Josefarc/TEI-201-Secci-n-4-Grupo-9/hardware/fotos/v1_03_detalle_conexiones_hx711.jpg.jpeg

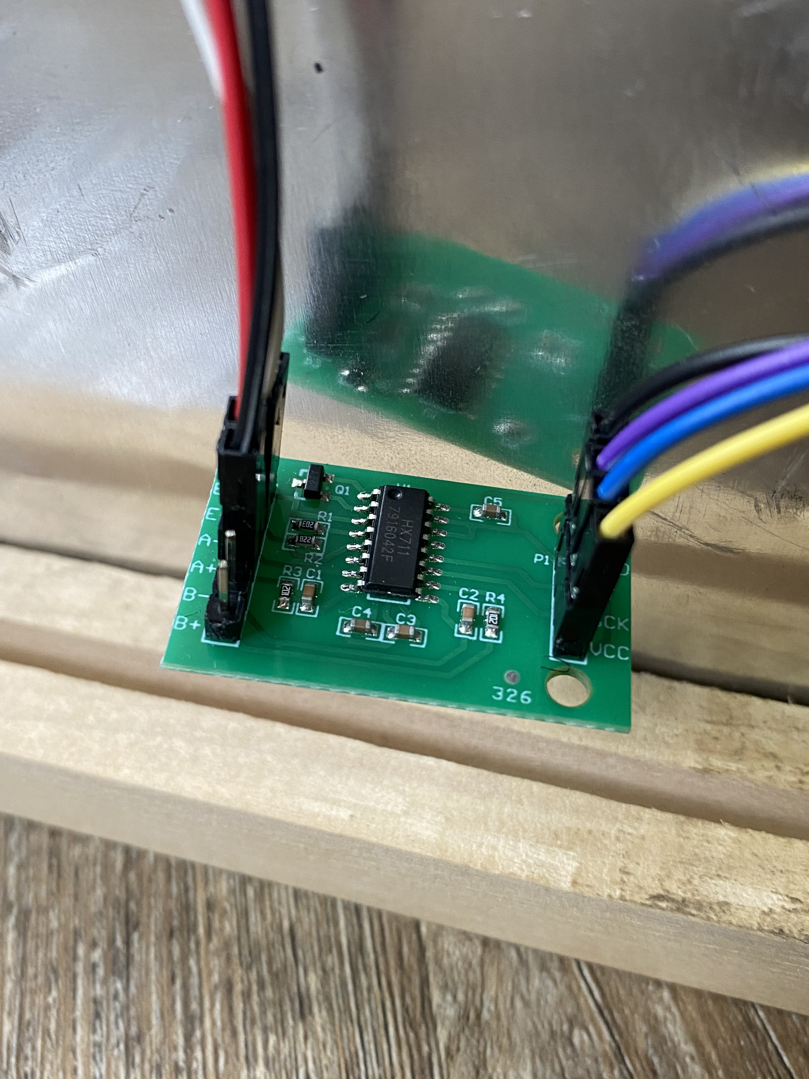
hardware/fotos/v1_03_detalle_conexiones_hx711.jpg.jpeg
