Josefarc/TEI-201-Secci-n-4-Grupo-9/diseno_3d/fusion360/README.md

## Nota para el ayudante — Entrega 2

En las carpetas de renders, Fusion y planos, la versión marcada como final es la que se debe evaluar para el Avance 2. Las demás se mantienen como historial de diseño, para que todo el equipo tenga visibilidad del progreso del proyecto.

El principal desafío pendiente es llevar el sistema a un mat de mayor área, con un diseño que se integre a la estética del dormitorio.

# Archivos Fusion 360

## Archivos Requeridos

### `modelo_completo_v3.f3d`
Archivo principal con **historial de cambios completo**

**DEBE INCLUIR:**
-  Todos los componentes modelados
-  Ensamble completo funcional
-  Historial de diseño (timeline)
-  Materiales asignados
-  Constraints y relaciones

---

## Estructura del Modelo

### Componentes (Components)
```
Ensamble_Principal
├── Encapsulado_Inferior
├── Encapsulado_Superior
├── ESP32_DevKit
├── Sensor_DHT22
├── LED_Indicador
├── Soporte_Bateria
├── Bracket_Montaje
└── Tornilleria
```

### Uniones (Joints)
Documentar las juntas principales y sus restricciones

### Parámetros
Listar parámetros principales utilizados:
- `ancho_total = 120mm`
- `alto_total = 80mm`
- `grosor_pared = 2mm`

---

## Instrucciones de Apertura

1. Abrir Fusion 360
2. File > Open > Seleccionar archivo `.f3d`
3. Verificar que todas las referencias están cargadas
4. Revisar timeline para ver historial

---

## Versiones

| Versión | Fecha | Cambios Principales |
|---|---|---|
| v3.0 | [Fecha] | Versión final para Avance #3 |
| v2.1 | [Fecha] | Ajustes post Avance #2 |
| v1.0 | [Fecha] | Primera versión funcional |

---
