Josefarc/TEI-201-Secci-n-4-Grupo-9/hardware/fotos/README.md

# Fotografías del Prototipo

## Requisitos de las Fotos

### Calidad
- **Resolución mínima:** 1920x1080 px
- **Formato:** JPG o PNG
- **Iluminación:** Buena iluminación natural o artificial uniforme
- **Fondo:** Neutro y sin distracciones

### Tomas Requeridas

1. **Vista general del prototipo completo**
2. **Vista del circuito interno**
3. **Detalle de conexiones críticas**
4. **Vista de sensores montados**
5. **Vista de actuadores**
6. **Encapsulado cerrado (si aplica)**
7. **Prototipo en contexto de uso**

---

## Nomenclatura
- Numerar según orden: `01_`, `02_`, etc.
- Usar nombres descriptivos
- Incluir versión: `v1_01_vista_general.jpg`

---

## Fotos de la Iteración 1 (v1)

| Archivo | Descripción |
|---|---|
| `v1_01_vista_general.jpg` | Sistema completo: prototipo del mat y circuito del control lado a lado |
| `v1_02_circuito_interno_mat.jpg` | Electrónica del mat (Wemos D1, HX711 y cableado desde las celdas) vista por debajo |
| `v1_03_detalle_conexiones_wemos_d1_mat.jpg` | Wemos D1 del mat: cables de datos del HX711 y de alimentación |
| `v1_03_detalle_conexiones_hx711.jpg` | HX711: cables de las celdas de carga (E+, E-, A+, A-) y hacia el Wemos D1 (DT, SCK, VCC) |
| `v1_03_detalle_conexiones_ups.jpg` | Módulo UPS con batería 18650: cables conectados a los pads 5V y GND |
| `v1_03_detalle_conexiones_protoboard_control.jpg` | Protoboard del control: buzzer, pulsador, transistor y resistencia con sus cables |
| `v1_03_detalle_conexiones_wemos_d1_mini_control.jpg` | Wemos D1 mini del control: cables al buzzer y al pulsador y de alimentación |
| `v1_04_sensores.jpg` | Mat sin la alfombra, con las 4 celdas de carga fijadas a la placa de aluminio |
| `v1_05_circuito_control.jpg` | Circuito del control en protoboard con Wemos D1 mini, buzzer, pulsador y módulo UPS con batería 18650 |
| `v1_06_mat_armado.jpg` | Mat armado con marco de madera y alfombra (solo mat, el control no está encapsulado) |
| `v1_07_contexto_uso.jpg` | No aplica en la iteración 1 (prototipo alpha, aún sin pruebas en contexto real) |
