Josefarc/TEI-201-Secci-n-4-Grupo-9/FUENTES.md

# Fuentes y referencias

## Librerías de software

| Librería | Uso | Enlace |
|---|---|---|
| HX711 (autor: bogde) | Lectura de las celdas de carga a través del amplificador HX711 | https://github.com/bogde/HX711 |
| ESP8266 Arduino Core (ESP8266WiFi, espnow) | Soporte de las placas ESP8266 y comunicación ESP-NOW | https://github.com/esp8266/Arduino |

**Instalación:**
- `HX711`: Arduino IDE → Gestor de Librerías → buscar "HX711" (autor: Bogdan Necula, bogde).
- Placas ESP8266: Arduino IDE → Preferencias → agregar la URL del gestor de placas del ESP8266 → Gestor de Placas → instalar "esp8266". Luego elegir la placa `LOLIN(WEMOS) D1 R2 & mini`.

## Hardware y datasheets

| Componente | Documento | Enlace |
|---|---|---|
| HX711 | Datasheet, Avia Semiconductor | https://cdn.sparkfun.com/datasheets/Sensors/ForceFlex/hx711_english.pdf |
| Celdas de carga 50 kg | Datasheet (`hardware/bom/datasheets/`) y ficha del vendedor | https://hubot.cl/producto/celda-de-carga-50-kg/ |
| ESP-NOW | Descripción del protocolo, Espressif | https://www.espressif.com/en/products/software/esp-now/overview |
| Wemos D1 Mini | Documentación de la placa | https://www.wemos.cc/en/latest/d1/d1_mini.html |
| Transistor 2N2222 | Ficha del vendedor | https://hubot.cl/producto/transistor-2n2222-to-92-sku-668h3/ |
| Módulo UPS con batería 18650 | Ficha del vendedor | https://hubot.cl/producto/modulo-cargador-usb-para-bateria-18650-v3-para-mcu-sku-672/ |

## Herramientas

- Arduino IDE 2.x
- Autodesk Fusion 360 (scripts en Python mediante su API). Documentación: https://help.autodesk.com/view/fusion360/ENU/
- GitHub Desktop

## Referencias del problema (ODS 3 y caídas en adultos mayores)

BAU Accesibilidad. (2025). *Senama: 43% de las caídas de adultos mayores se produce en sus viviendas*. https://bauaccesibilidad.cl/blogs/news/adaptabilidad-universal-vivienda-adultos-mayores

Portal Red Salud. (2025, 27 octubre). *Mes del Adulto Mayor: Los riesgos de las caídas y la complejidad de la recuperación*. https://portalredsalud.cl/2025/10/27/mes-del-adulto-mayor-los-riesgos-de-las-caidas-y-la-complejidad-de-la-recuperacion/

Anthropic. (2026). *Claude* [Modelo de lenguaje de gran escala]. https://claude.ai

## Uso de inteligencia artificial

Para la elaboración de este proyecto se utilizó apoyo de inteligencia artificial (Claude, Anthropic) en la redacción, corrección ortográfica, búsqueda de materiales, elaboración de código y formato de las fuentes en estilo APA.
