Josefarc/TEI-201-Secci-n-4-Grupo-9/diseno_3d/renders/README.md

# Renders de Alta Calidad
## Nota para el ayudante — Entrega 2

En las carpetas de renders, Fusion y planos, la versión marcada como final es la que se debe evaluar para el Avance 2. Las demás se mantienen como historial de diseño, para que todo el equipo tenga visibilidad del progreso del proyecto.

El principal desafío pendiente es llevar el sistema a un mat de mayor área, con un diseño que se integre a la estética del dormitorio.
## Renders Requeridos (Mínimo 4 ángulos)

### 1. Vista Isométrica Frontal
`01_isometrica_frontal.png`
- Muestra exterior completo
- Iluminación clara
- Resolución: 1920×1080 mínimo

### Renders Opcionales (Recomendados)
- `02_detalle_sensores.png` - Close-up de sensores
- `03_ensamble_explosionado.png` - Componentes separados
- `04_variantes_color.png` - Si hay opciones de diseño

---

## Configuración de Render en Fusion 360

### Settings Recomendados
- **Render Engine:** Local / Cloud
- **Environment:** [Tipo de iluminación]
- **Resolution:** 1920×1080 o superior
- **Quality:** High
- **Exposure:** [Ajustado para visibilidad]
- **Effects:** Ambient Occlusion ON

### Materiales y Apariencias
Asignar materiales realistas:
- Plástico: PLA/ABS mate o satinado
- Electrónica: PCB verde, componentes negros
- Metales: Tornillos acero inoxidable

---

## Nomenclatura de Archivos
```
[numero]_[descripcion]_[version].png

Ejemplo:
01_isometrica_frontal_v3.png
```

---

## Checklist de Calidad

- [ ] Resolución mínima 1920×1080
- [ ] Formato PNG (con transparencia si aplica)
- [ ] Iluminación sin sombras excesivas
- [ ] Componentes internos visibles en corte
- [ ] Fondo neutro o contextual apropiado
- [ ] Sin aliasing o bordes pixelados
- [ ] Todos los componentes críticos visibles
