Josefarc/TEI-201-Secci-n-4-Grupo-9/hardware/esquemas/esquema_control.png

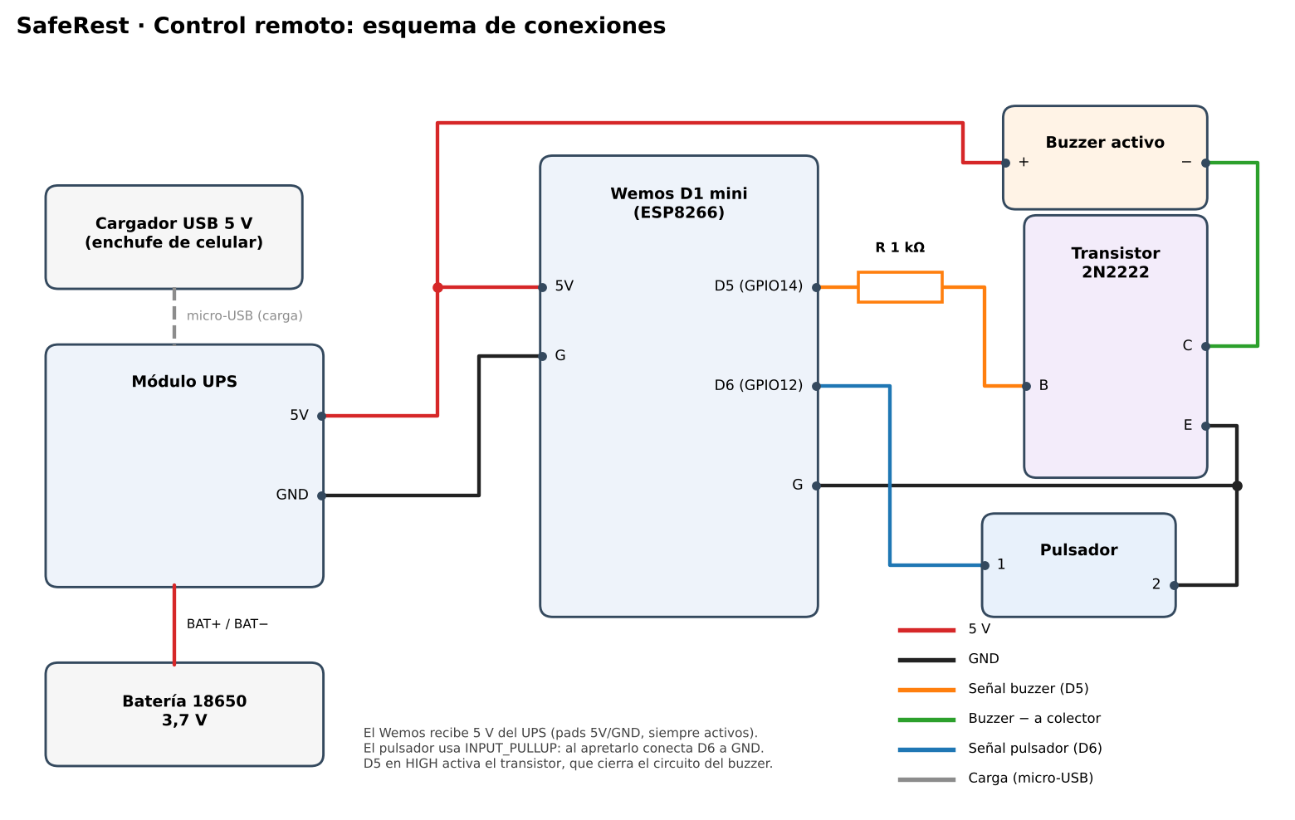
hardware/esquemas/esquema_control.png
