Josefarc/TEI-201-Secci-n-4-Grupo-9/hardware/esquemas/esquema_mat.png

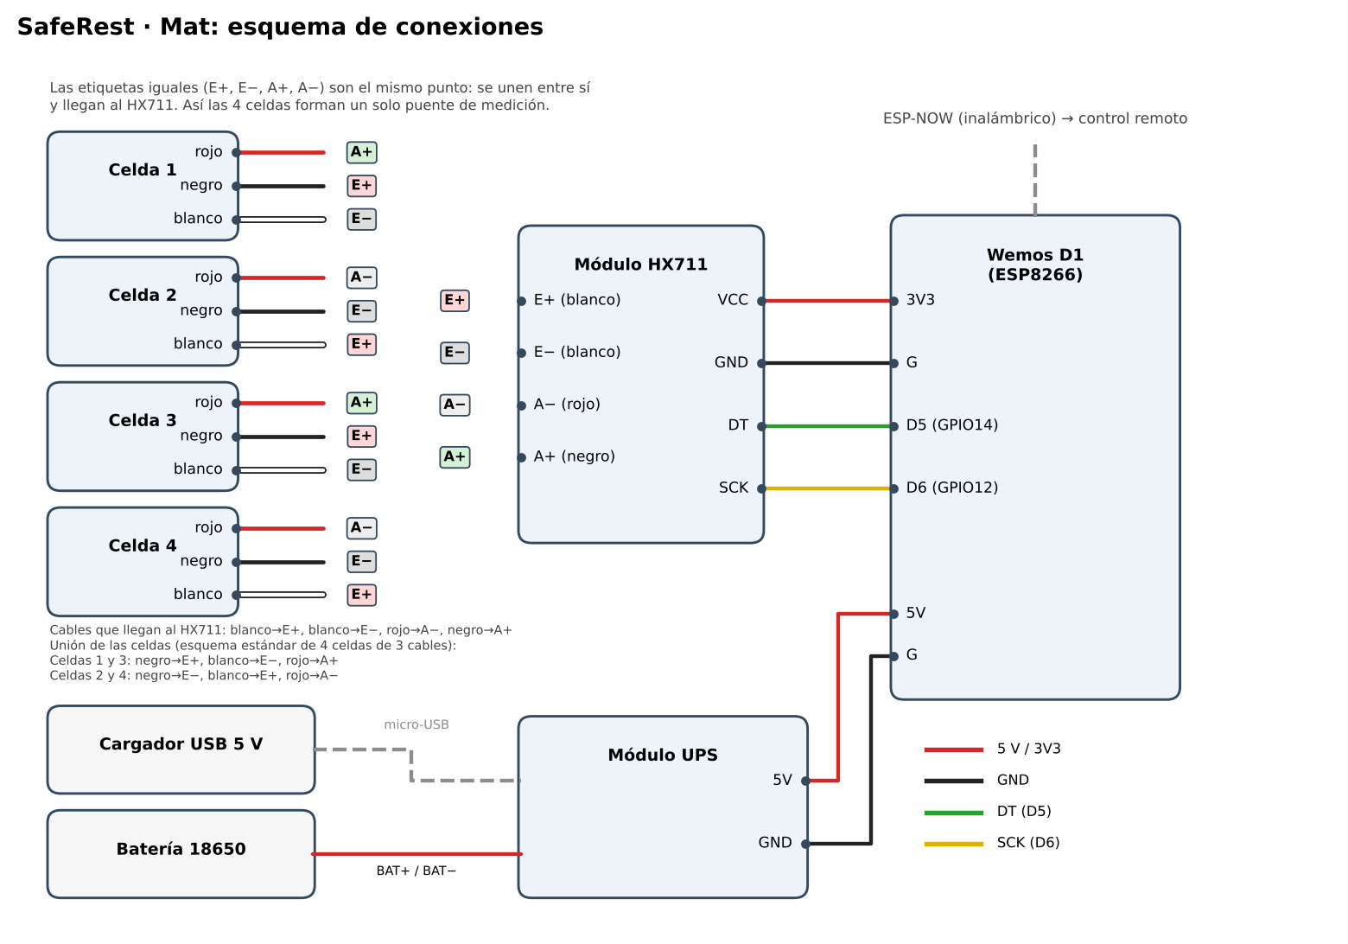
hardware/esquemas/esquema_mat.png
