Josefarc/TEI-201-Secci-n-4-Grupo-9/hardware/fotos/v1_03_detalle_conexiones_protoboard_control.jpg.jpeg

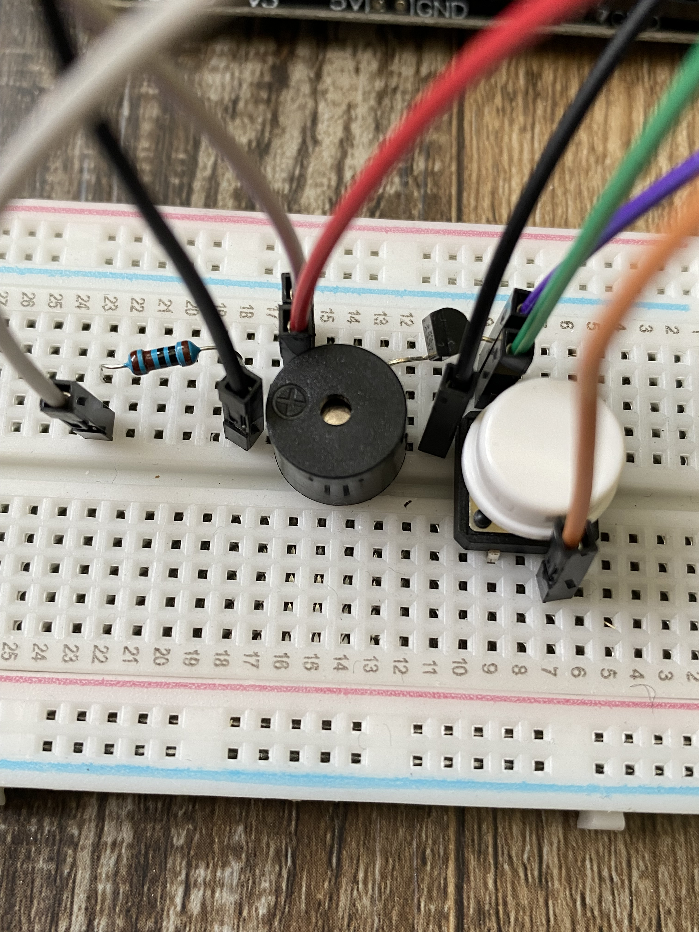
hardware/fotos/v1_03_detalle_conexiones_protoboard_control.jpg.jpeg
