Josefarc/TEI-201-Secci-n-4-Grupo-9/hardware/bom/bom_completo.xlsx

Sheet: BOM
SafeRest - Bill of Materials (BOM)
Solo materiales usados hasta ahora. Se agregarán filas a medida que avance el proyecto.
Sistema | Categoría | Cantidad | Componente | Especificación | Fabricante | Código | Proveedor | Precio Unitario (CLP) | Precio Total (CLP) | Datasheet
Mat | Sensores | 4 | Celda de carga 50 kg (tipo barra) | 50 kg, con 4 celdas en el mat | Genérico | 599 | https://hubot.cl/producto/celda-de-carga-50-kg/ | $2400 | $9600 | celda_carga_datasheet.pdf (https://cdn.sparkfun.com/assets/1/9/7/7/b/loadsensor.pdf)
Mat | Sensores | 1 | Módulo amplificador HX711 | Amplificador de celdas de carga | Kuongshun | 1314 | https://afel.cl/products/sensor-peso-y-presion-transmisor-de-celda-de-carga-hx711?_pos=2&_sid=12394d1de&_ss=r | $2300 | $2300 | HX711_datasheet.pdf (https://cdn.sparkfun.com/datasheets/Sensors/ForceFlex/hx711_english.pdf)
Mat | Microcontrolador | 1 | Wemos D1 (ESP8266) | Formato Uno, WiFi/ESP-NOW | Kuongshun | 1345 | https://afel.cl/products/wemos-d1-wifi-esp8266-microcontrolador?variant=45125241274520 | $8490 | $8490 | https://afel.cl/products/wemos-d1-wifi-esp8266-microcontrolador?variant=45125241274520
Mat | Otros | 1 | Cables de conexión (1mt) | Jumpers para el prototipo | Genérico | 1412 | https://afel.cl/products/cable-dupont-plano-40-pines-1mt?variant=45125273223320 | $3000 | $3000
Control | Microcontrolador | 1 | Wemos D1 mini (ESP8266) | ESP-NOW | Kuongshun | 1513 | https://afel.cl/products/wemos-d1-mini-esp8266-wifi-esp-12f?variant=45125214142616 | $4990 | $4990 | https://afel.cl/products/wemos-d1-mini-esp8266-wifi-esp-12f?variant=45125214142616
Control | Actuadores | 1 | Buzzer | Alerta sonora | Genérico | 1451 | https://afel.cl/products/buzzer-activo?variant=45125217190040 | $300 | $300
Control | Otros | 1 | Pulsador (botón) | Silencia la alarma | Genérico | 1027 | https://afel.cl/products/boton-tactil-tapa-12x12x7-3-interruptor?variant=45125247631512 | $100 | $100
Control | Otros | 1 | Módulo UPS con USB-A y micro-USB | Con interruptor ON/OFF | Genérico | 672 | https://hubot.cl/producto/modulo-cargador-usb-para-bateria-18650-v3-para-mcu-sku-672/ | $4290 | $4290 | https://hubot.cl/producto/modulo-cargador-usb-para-bateria-18650-v3-para-mcu-sku-672/
Control | Otros | 1 | Batería 18650 | Li-ion 3,7 V | Kuongshun | 2933 | https://afel.cl/products/bateria-recargable-18650-3-7v-1800mah?variant=47345143513240 | $2000 | $2000 | https://afel.cl/products/bateria-recargable-18650-3-7v-1800mah?variant=47345143513240
Control | Otros | 1 | Protoboard | Prototipo (luego se cambia por perfboard) | Genérico | 1226 | https://afel.cl/products/mini-protoboard-400-puntos?variant=45125249663128 | $1500 | $1500
Control | Otros | 1 | Cargador USB 5 V (enchufe de celular) | Carga el UPS | Genérico | 453 | https://hubot.cl/producto/adaptador-dc-raspberry-pi-3-5v-3-amperes/ | $5600 | $5600
Control | Otros | 1 | Cable micro-USB |  | Genérico | MCI08003 | https://mcielectronics.cl/shop/product/cable-micro-usb-30cm/ | $1690 | $1690
Control | Otros | 1 | Cables de conexión (lote) | Jumpers para el prototipo | Genérico | 1135 | https://afel.cl/products/pack-60-cables-de-conexion?variant=45125231935640 | $2500 | $2500
Control | Otros | 1 | Transistor 2N2222 | NPN TO-92, activa el buzzer desde D5 (datasheet de la variante P2N2222A) | Genérico | 668 | https://hubot.cl/producto/transistor-2n2222-to-92-sku-668h3/ | $160 | $160 | https://www.onsemi.com/pdf/datasheet/p2n2222a-d.pdf
Control | Otros | 1 | Resistencia 1 kΩ | 1 kΩ, entre D5 y la base del transistor | Genérico | 406-1 | https://hubot.cl/producto/20-resistencias-14w-1-distintos-valores/ | $600 | $600
 |  |  |  |  |  |  |  |  | $0
 |  |  |  |  |  |  |  | TOTAL | $47120

Sheet: Resumen
Presupuesto por categoría (CLP)
Categoría | Mat | Control | Total
Microcontrolador | $8490 | $4990 | $13480
Sensores | $11900 | $0 | $11900
Actuadores | $0 | $300 | $300
Estructura | $0 | $0 | $0
Otros | $3000 | $18440 | $21440
TOTAL | $23390 | $23730 | $47120
Control de cuadratura (debe ser 0): |  |  | 0
