Josefarc/TEI-201-Secci-n-4-Grupo-9/(list of files, cad)

Other CAD files:
diseno_3d/fusion360/ matt v2.f3d
diseno_3d/fusion360/ matt.f3d
diseno_3d/fusion360/dispositivo.f3d
diseno_3d/fusion360/pulsador.f3d
diseno_3d/renders/Render matt v2.f3d
diseno_3d/renders/Render matt.f3d
diseno_3d/renders/final.f3d
diseno_3d/renders/pulsador render.f3d
