Josefarc/TEI-201-Secci-n-4-Grupo-9/testing/README.md

# Testing y Validación

## Objetivo
Validar el funcionamiento del prototipo con usuarios reales y medir el impacto cuantitativo en la problemática ODS seleccionada.

---

## 📁 Carpetas

#### `reportes/`
Documentos con resultados del testing

#### `evidencias/`
Fotos y videos de sesiones con usuarios

#### `datos/`
Datos cuantitativos recolectados

---

## Metodología de Testing

### Grupo Objetivo
- **Perfil de usuarios:** Cuidadores formales o informales de adultos mayores de 65 años con movilidad reducida
- **Cantidad mínima:** 5 usuarios
- **Ubicación:** Dormitorio o habitación de reposo

### Protocolo de Testing
1. **Briefing** (5 min)
Validar una alfombra con sensores de carga para alertar salidas de cama y prevenir caídas nocturnas.  
2. **Sesión de Uso** (15-20 min)
   - Usuario interactúa con prototipo
   - Observación sin intervención
   - Toma de notas

3. **Entrevista Post-Testing** (10 min)
   - Preguntas sobre experiencia
   - Feedback cualitativo
   - Sugerencias de mejora

4. **Encuesta Cuantitativa** (5 min)
   - Escala Likert (1-5)
   - Métricas específicas

---

## Métricas de Evaluación

### Usabilidad
- Facilidad de uso (1-5)
- Claridad de funcionamiento (1-5)
- Satisfacción general (1-5)

### Impacto ODS
- [Métrica específica 1 relacionada con ODS]
- [Métrica específica 2 relacionada con ODS]
- [Métrica específica 3 relacionada con ODS]

### Desempeño Técnico
- Tiempo de respuesta del sistema
- Tasa de errores
- Confiabilidad

---

## Análisis de Resultados

### Cuantitativo
- Promedios y desviaciones estándar
- Gráficos de resultados
- Comparación con baseline

### Cualitativo
- Temas recurrentes en feedback
- Problemas identificados
- Sugerencias de mejora

---

## Validación de Impacto ODS

**ODS Seleccionado:** [Número y nombre]

**Meta específica del proyecto:** [Describir]

**Indicadores de impacto:**
1. [Indicador 1] - Baseline: [X], Meta: [Y], Alcanzado: [Z]
2. [Indicador 2] - Baseline: [X], Meta: [Y], Alcanzado: [Z]

**Proyección de impacto a escala:**
[Si el prototipo se despliega en toda la ciudad/comunidad, cuál sería el impacto estimado]
