Josefarc/TEI-201-Secci-n-4-Grupo-9/diseno_3d/planos/matt Dibujo.pdf

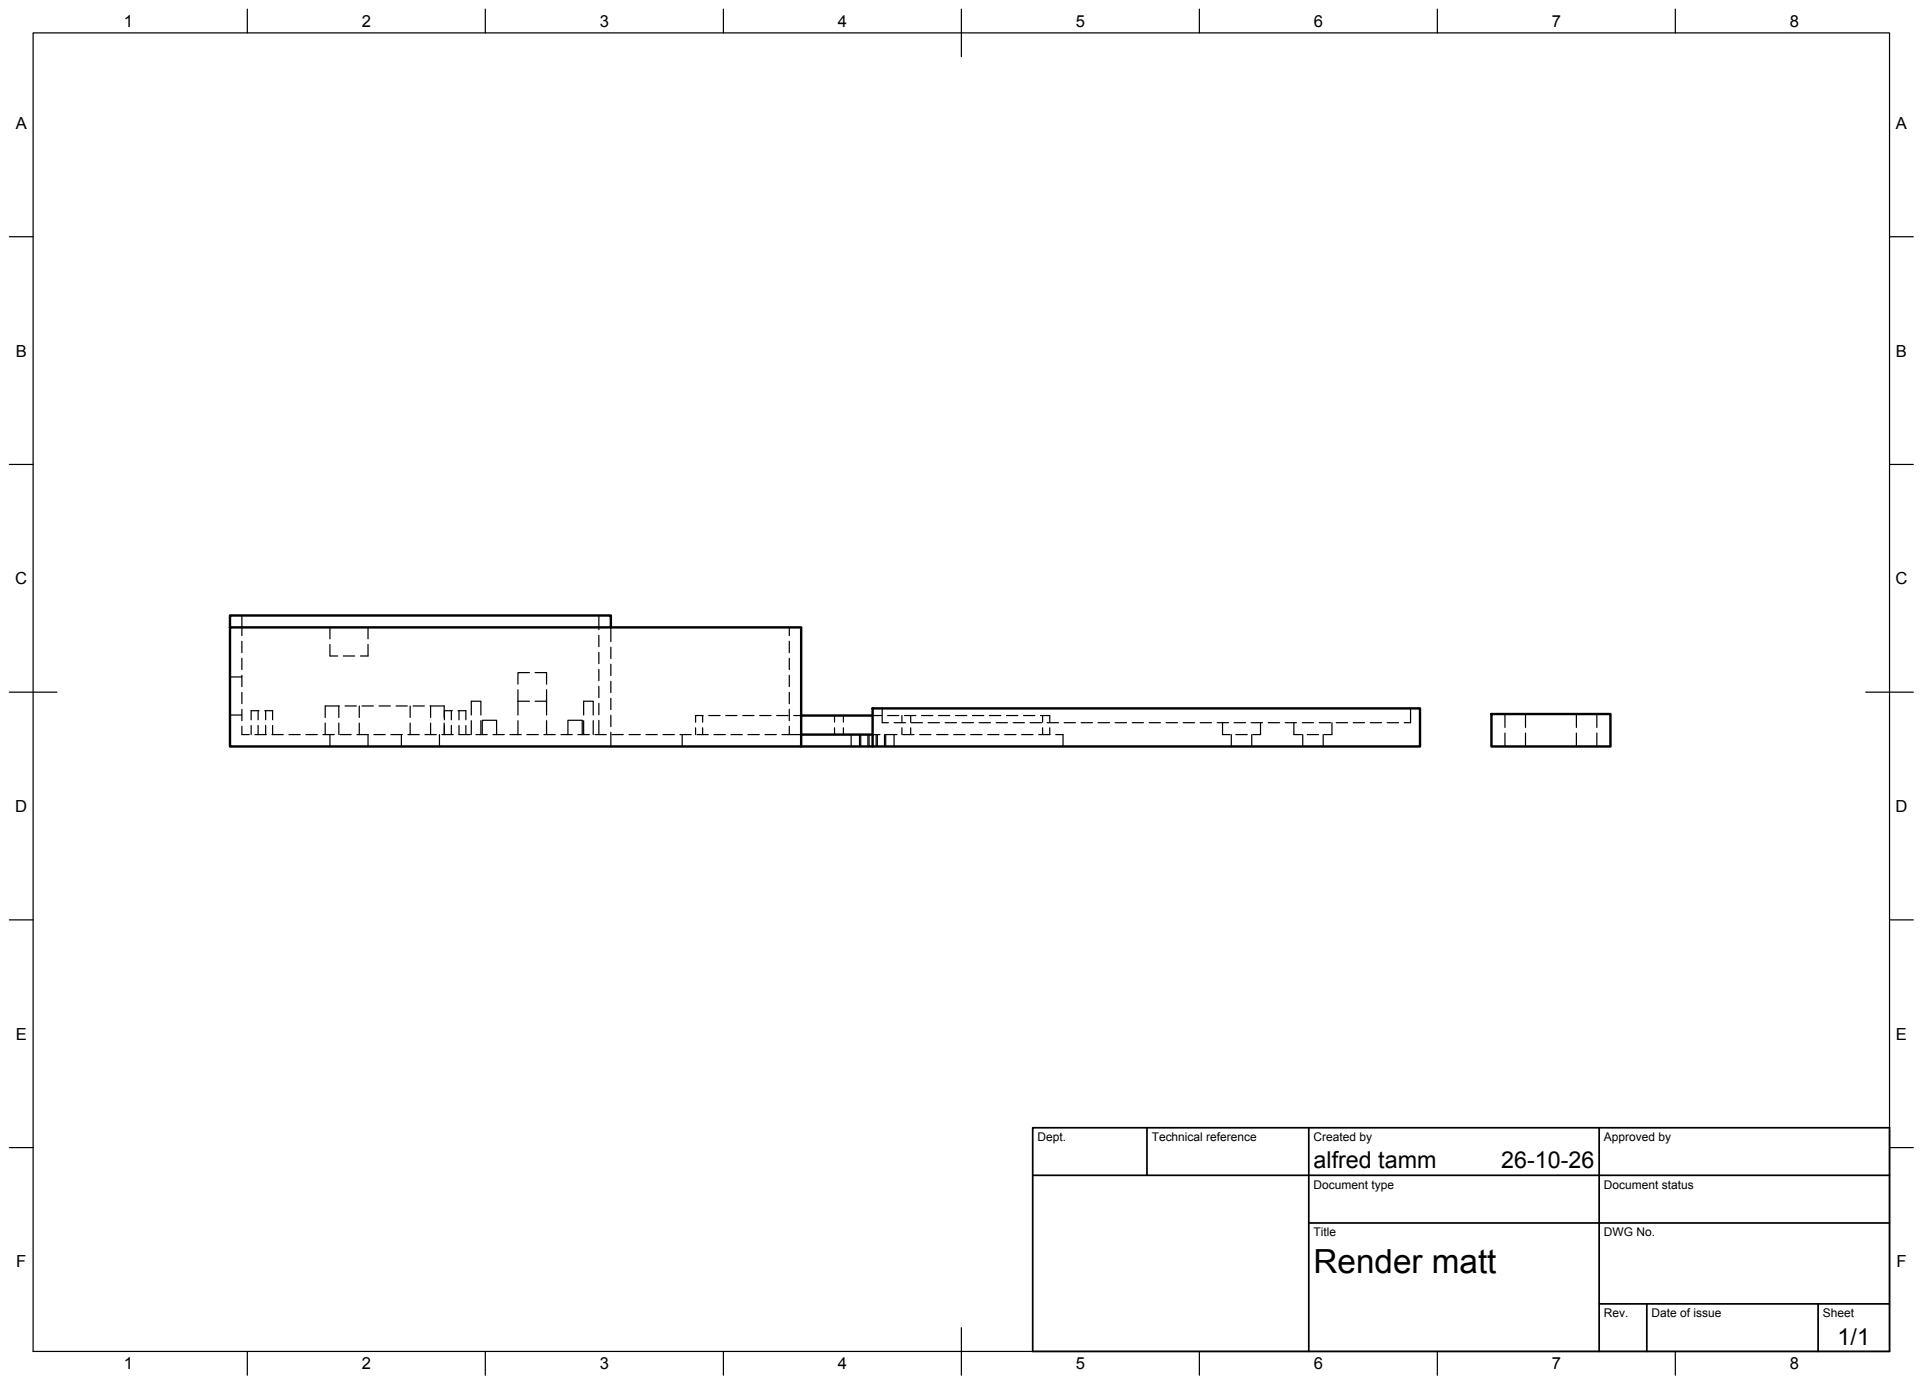
[picture p15: page 1]
Title; DWG No.; Rev.; Date of issue; Sheet; Render matt

Dept. | Technical reference | Created by alfred tamm 26-10-26 | Approved by

Document type | Document status
