Josefarc/TEI-201-Secci-n-4-Grupo-9/diseno_3d/planos/Sin título.pdf

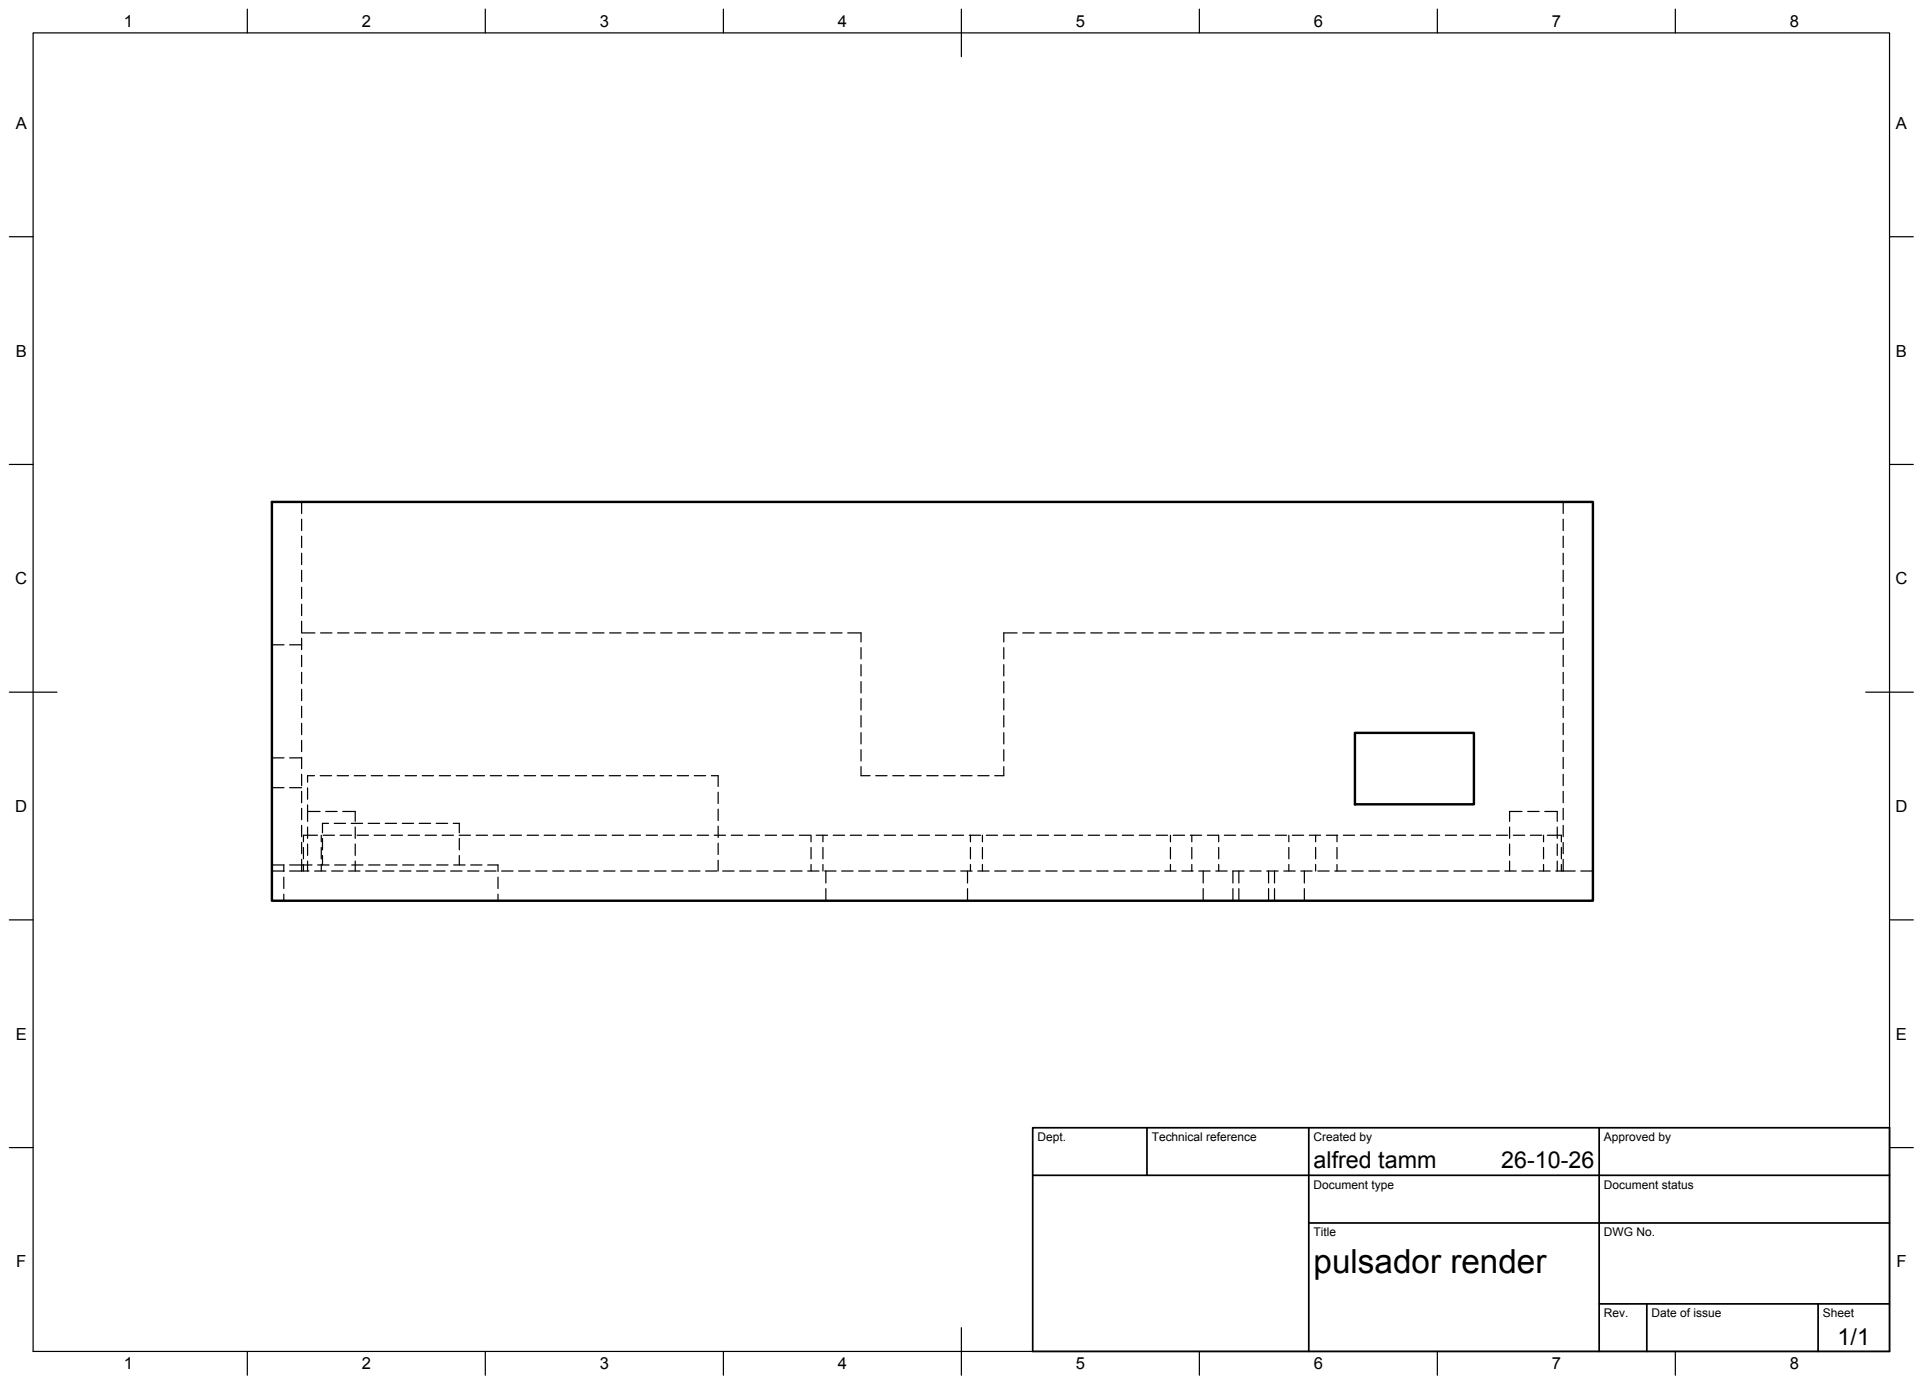
[picture p16: page 1]
Title; DWG No.; Rev.; Date of issue; Sheet; pulsador render

Dept. | Technical reference | Created by alfred tamm 26-10-26 | Approved by

Document type | Document status
