Josefarc/TEI-201-Secci-n-4-Grupo-9/hardware/fotos/v1_02_circuito_interno_mat.jpg.jpeg

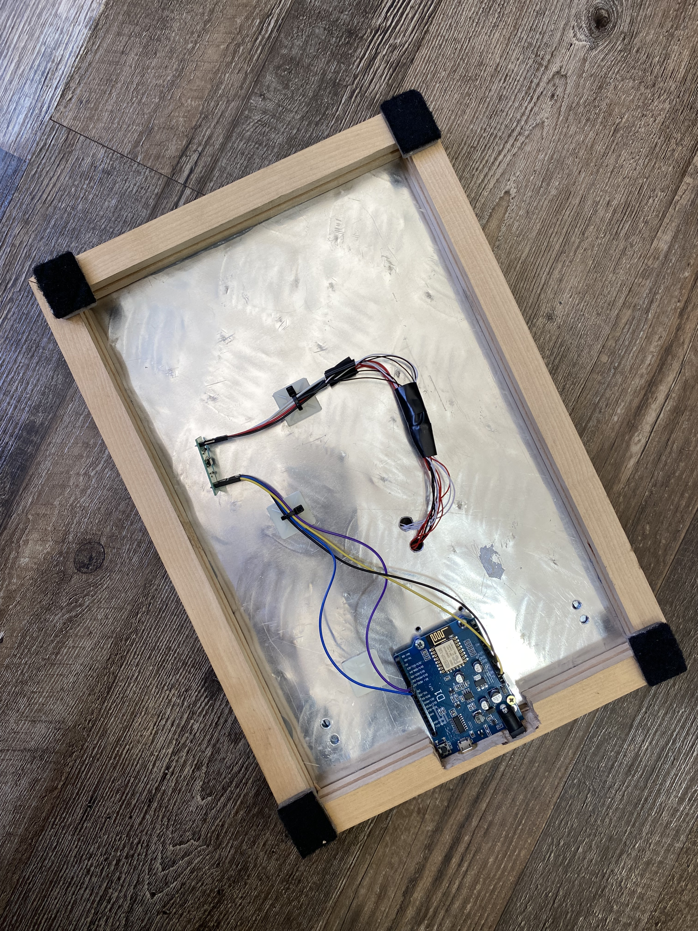
hardware/fotos/v1_02_circuito_interno_mat.jpg.jpeg
