Josefarc/TEI-201-Secci-n-4-Grupo-9/hardware/fotos/v1_04_sensores.jpg.jpeg

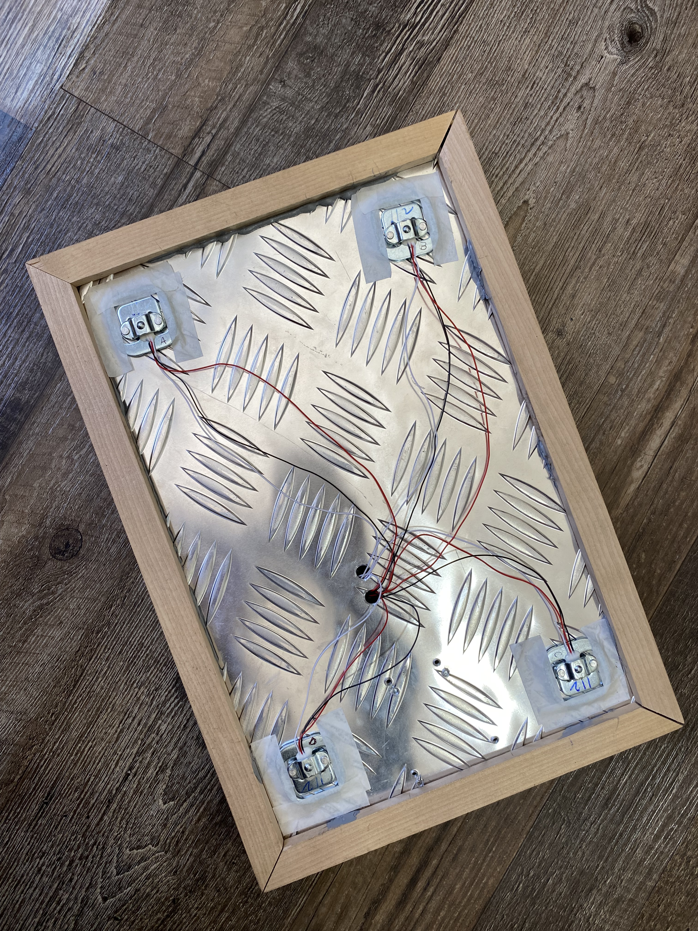
hardware/fotos/v1_04_sensores.jpg.jpeg
