Josefarc/TEI-201-Secci-n-4-Grupo-9/hardware/fotos/v1_06_mat_armado.jpg.jpeg

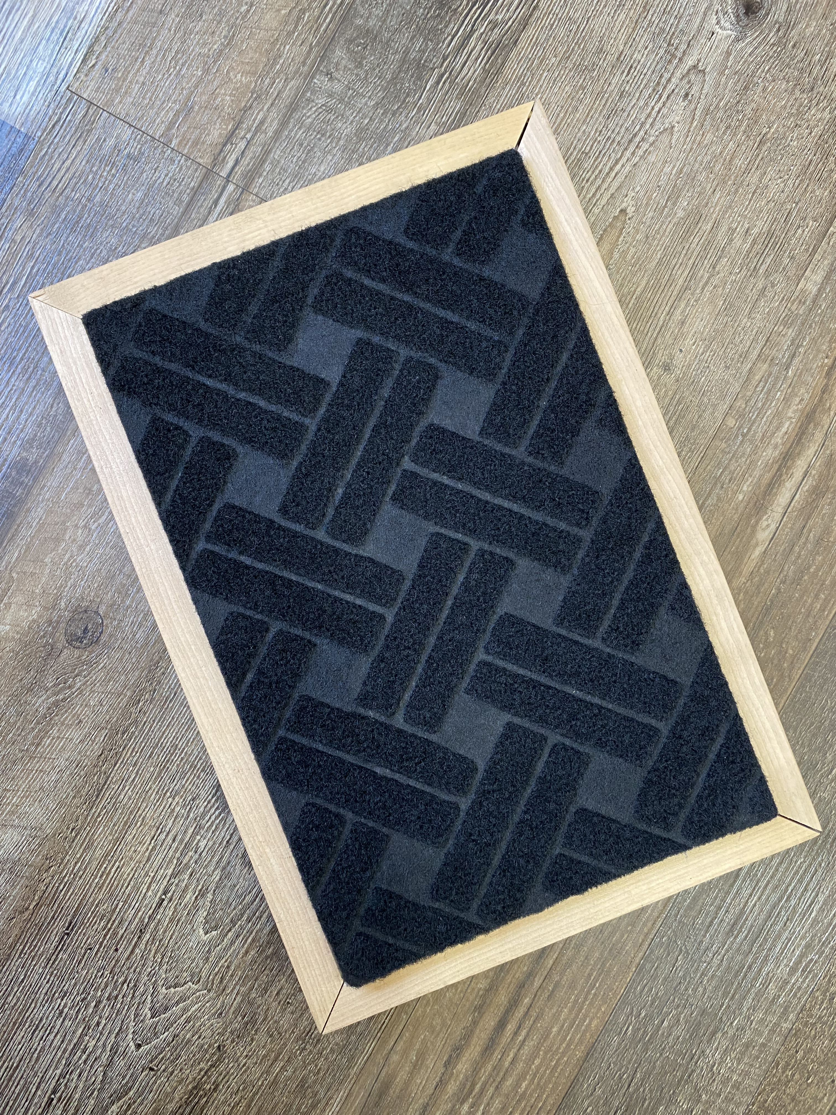
hardware/fotos/v1_06_mat_armado.jpg.jpeg
