Josefarc/TEI-201-Secci-n-4-Grupo-9/hardware/fotos/v1_01_vista_general.jpg.jpeg

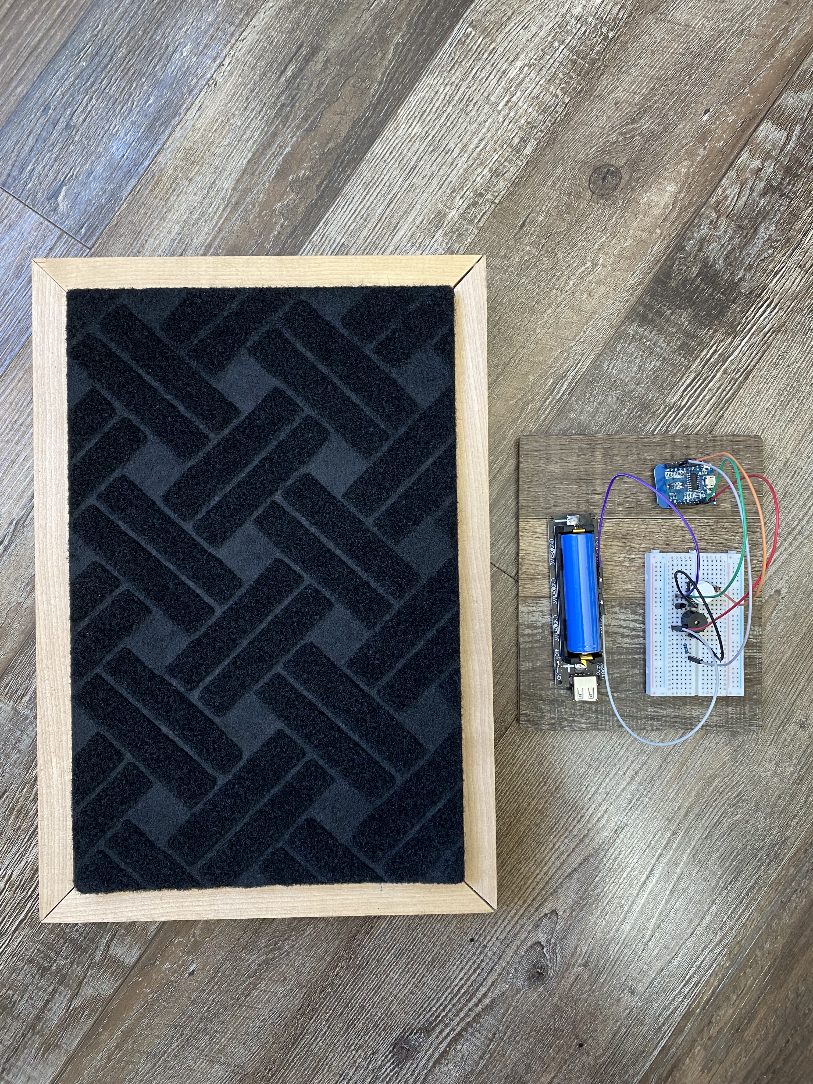
hardware/fotos/v1_01_vista_general.jpg.jpeg
